N1k0droid/ESP32-Oukitel-P800-SmartUPS/(notices)

Notices in the files:
README.md:
License: GPL v3
